h3esawy/OpenWaterHub/README.md

# OpenWaterHub
OpenWater Hub: An Open-Source Hardware Platform for Marine Robotics Support and Water Quality Data Acquisition
