h3esawy/OpenWaterHub/02_Mechanical_CAD/PortableLab_FrontPanel.DXF

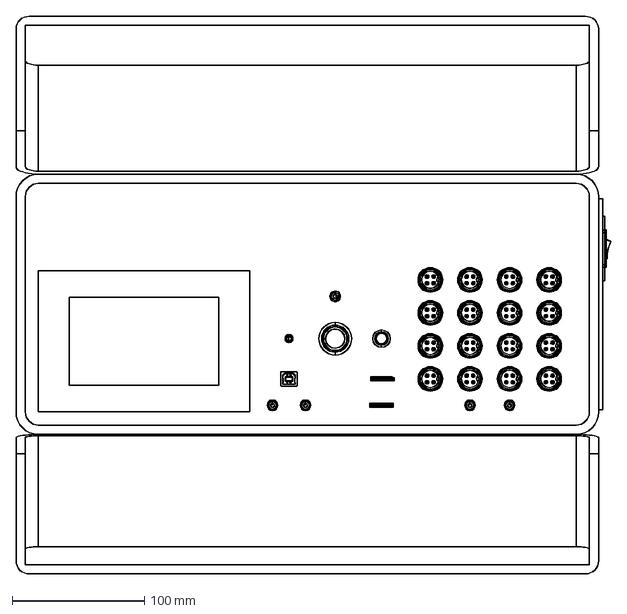
[picture p1: CAD file, 2026-06-13]
02_Mechanical_CAD/PortableLab_FrontPanel.DXF
450.4 x 422.2 mm
