h3esawy/OpenWaterHub/03_Firmware/ATmega128 MegaCore minimal setup.png

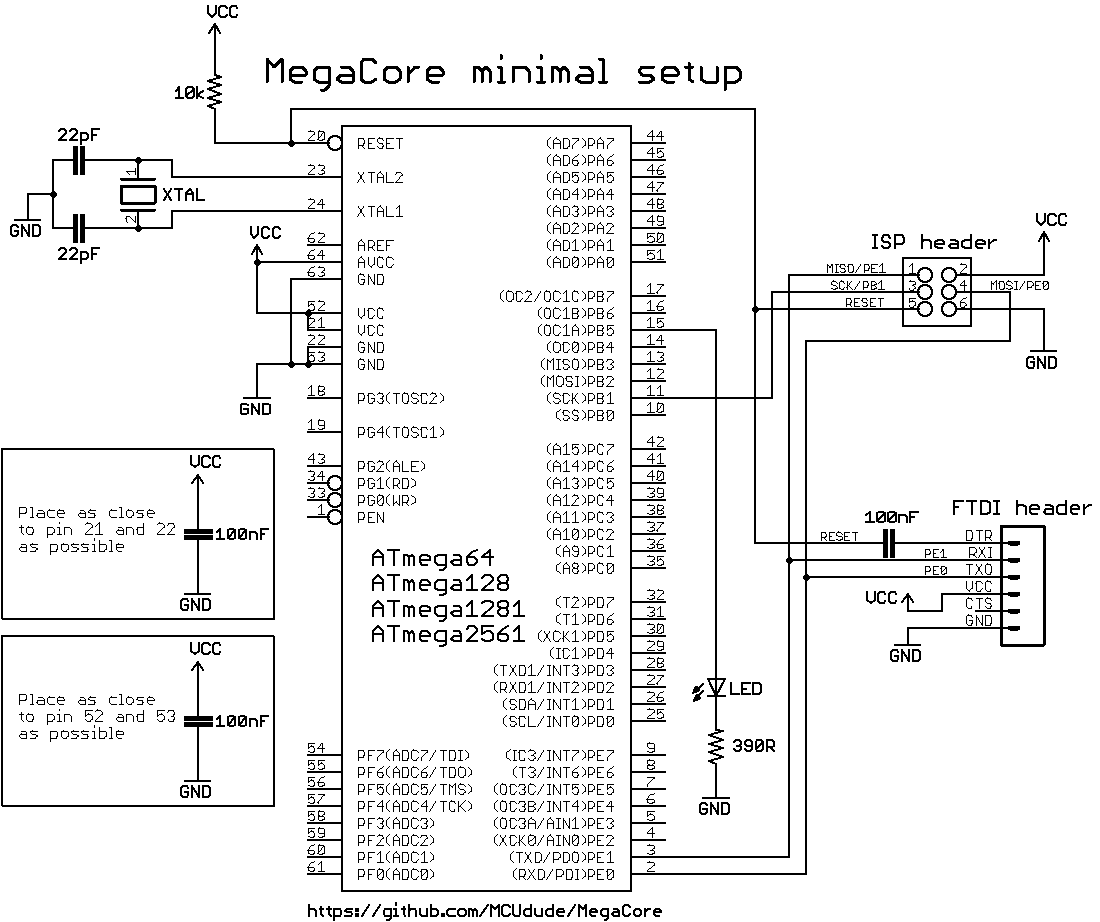
03_Firmware/ATmega128 MegaCore minimal setup.png
