h3esawy/OpenWaterHub/01_Hardware_PCB/OpenWaterHub_Schematic_Annotated.pdf

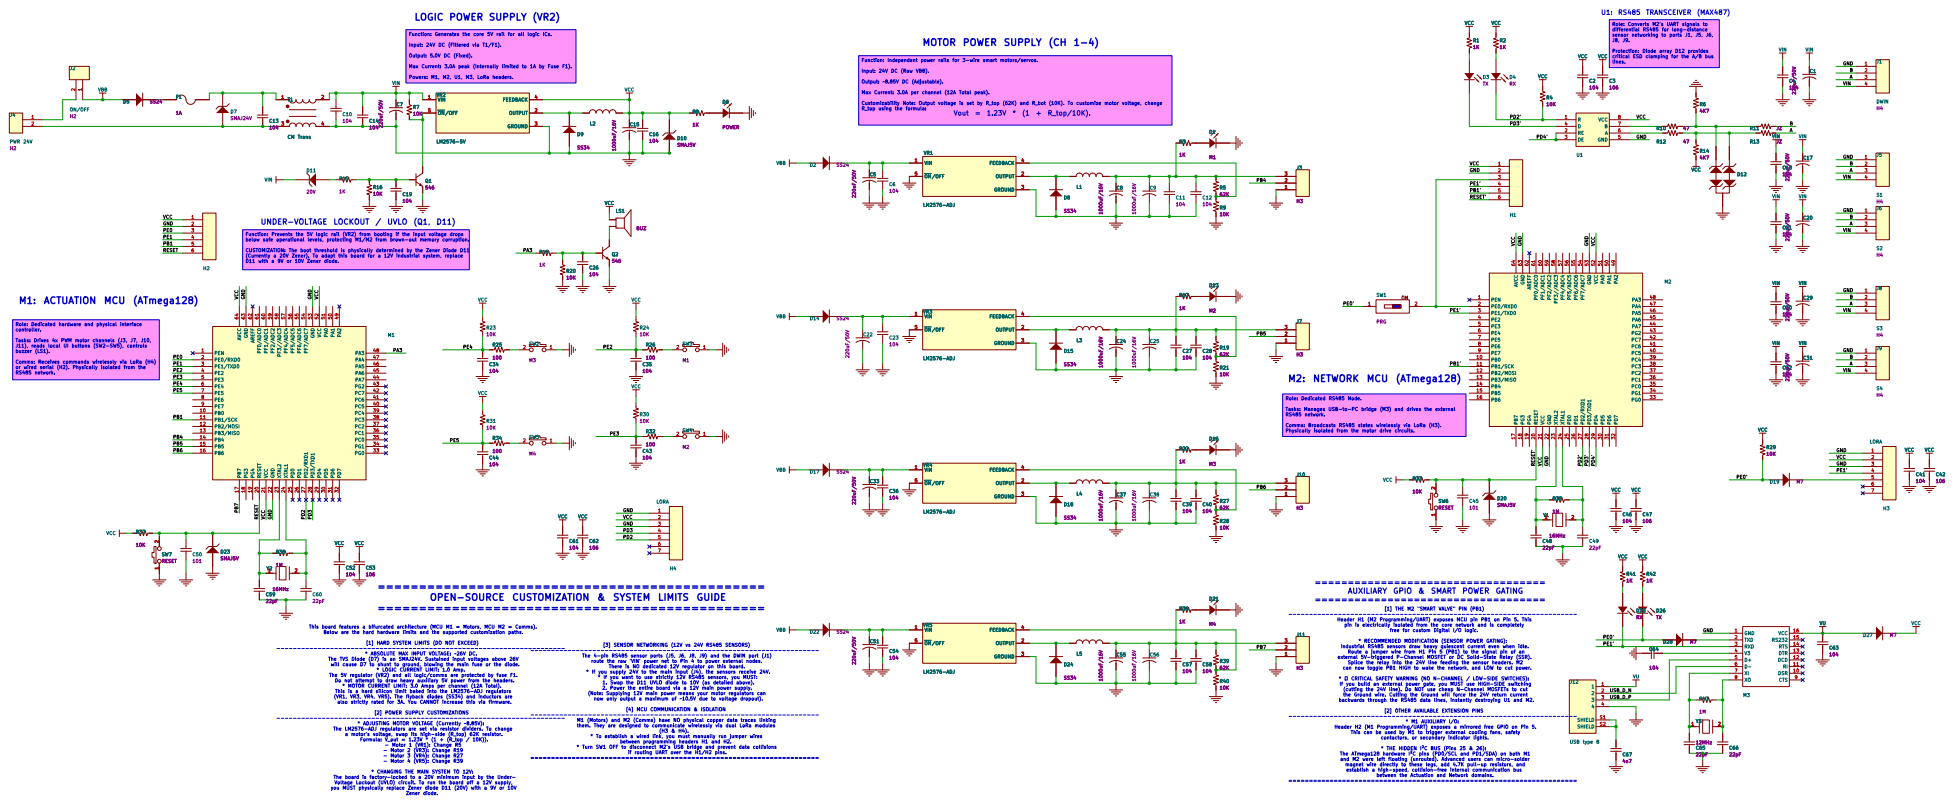
[picture p3: page 1]

Role: Converts M2's UART signals to
differential RS485 for long-distance

Function: Generates the core 5V rail for all logic ICs.

Input: 24V DC (Filtered via T1/F1).

Function: Independent power rails for 3-wire smart motors/servos.

lines. Role: Dedicated RS485 Node. Tasks: Manages USB-to-PC bridge (M3) and drives the external RS485 network. Comms: Broadcasts RS485 states wirelessly via LoRa (H3).

Input: 24V DC (Raw VBB).

Output: ~8.85V DC (Adjustable). Max Current: 3.0A per channel (12A Total peak).

UNDER-VOLTAGE LOCKOUT / UVLO (Q1, D11)

AUXILIARY GPIO & SMART POWER GATING =================================== M2: NETWORK MCU (ATmega128)

OPEN-SOURCE CUSTOMIZATION & SYSTEM LIMITS GUIDE

[1] THE M2 "SMART VALVE" PIN (PB1) ----------------------------------------------------------------------

free for custom Digital I/O logic. * RECOMMENDED MODIFICATION (SENSOR POWER GATING):

[1] HARD SYSTEM LIMITS (DO NOT EXCEED) ----------------------------------------------------------------------

[3] SENSOR NETWORKING (12V vs 24V RS485 SENSORS) ----------------------------------------------------------------------

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

* ABSOLUTE MAX INPUT VOLTAGE: ~26V DC.

route the raw 'VIN' power net to Pin 4 to power external nodes.

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

This is a hard silicon limit baked into the LM2576-ADJ regulators

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

M1 (Motors) and M2 (Comms) have NO physical copper data traces linking

* ADJUSTING MOTOR VOLTAGE (Currently ~8.85V):

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

* Turn SW1 OFF to disconnect M2's USB bridge and prevent data collisions

if routing UART over the H1/H2 pins. ======================================================================

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

you MUST physically replace Zener diode D11 (20V) with a 9V or 10V Zener diode.
