h3esawy/OpenWaterHub/(list of files, drawings)

Other design files:
01_Hardware_PCB/Altium_Source_Files/Schematic.SchDoc
01_Hardware_PCB/Altium_Source_Files/WaterRobot.PrjPcb
