h3esawy/OpenWaterHub/01_Hardware_PCB/KiCad_Source_Files/OpenWaterHub.kicad_sch

## KiCad design 01_Hardware_PCB/KiCad_Source_Files/OpenWaterHub.kicad_sch (2026-06-14)

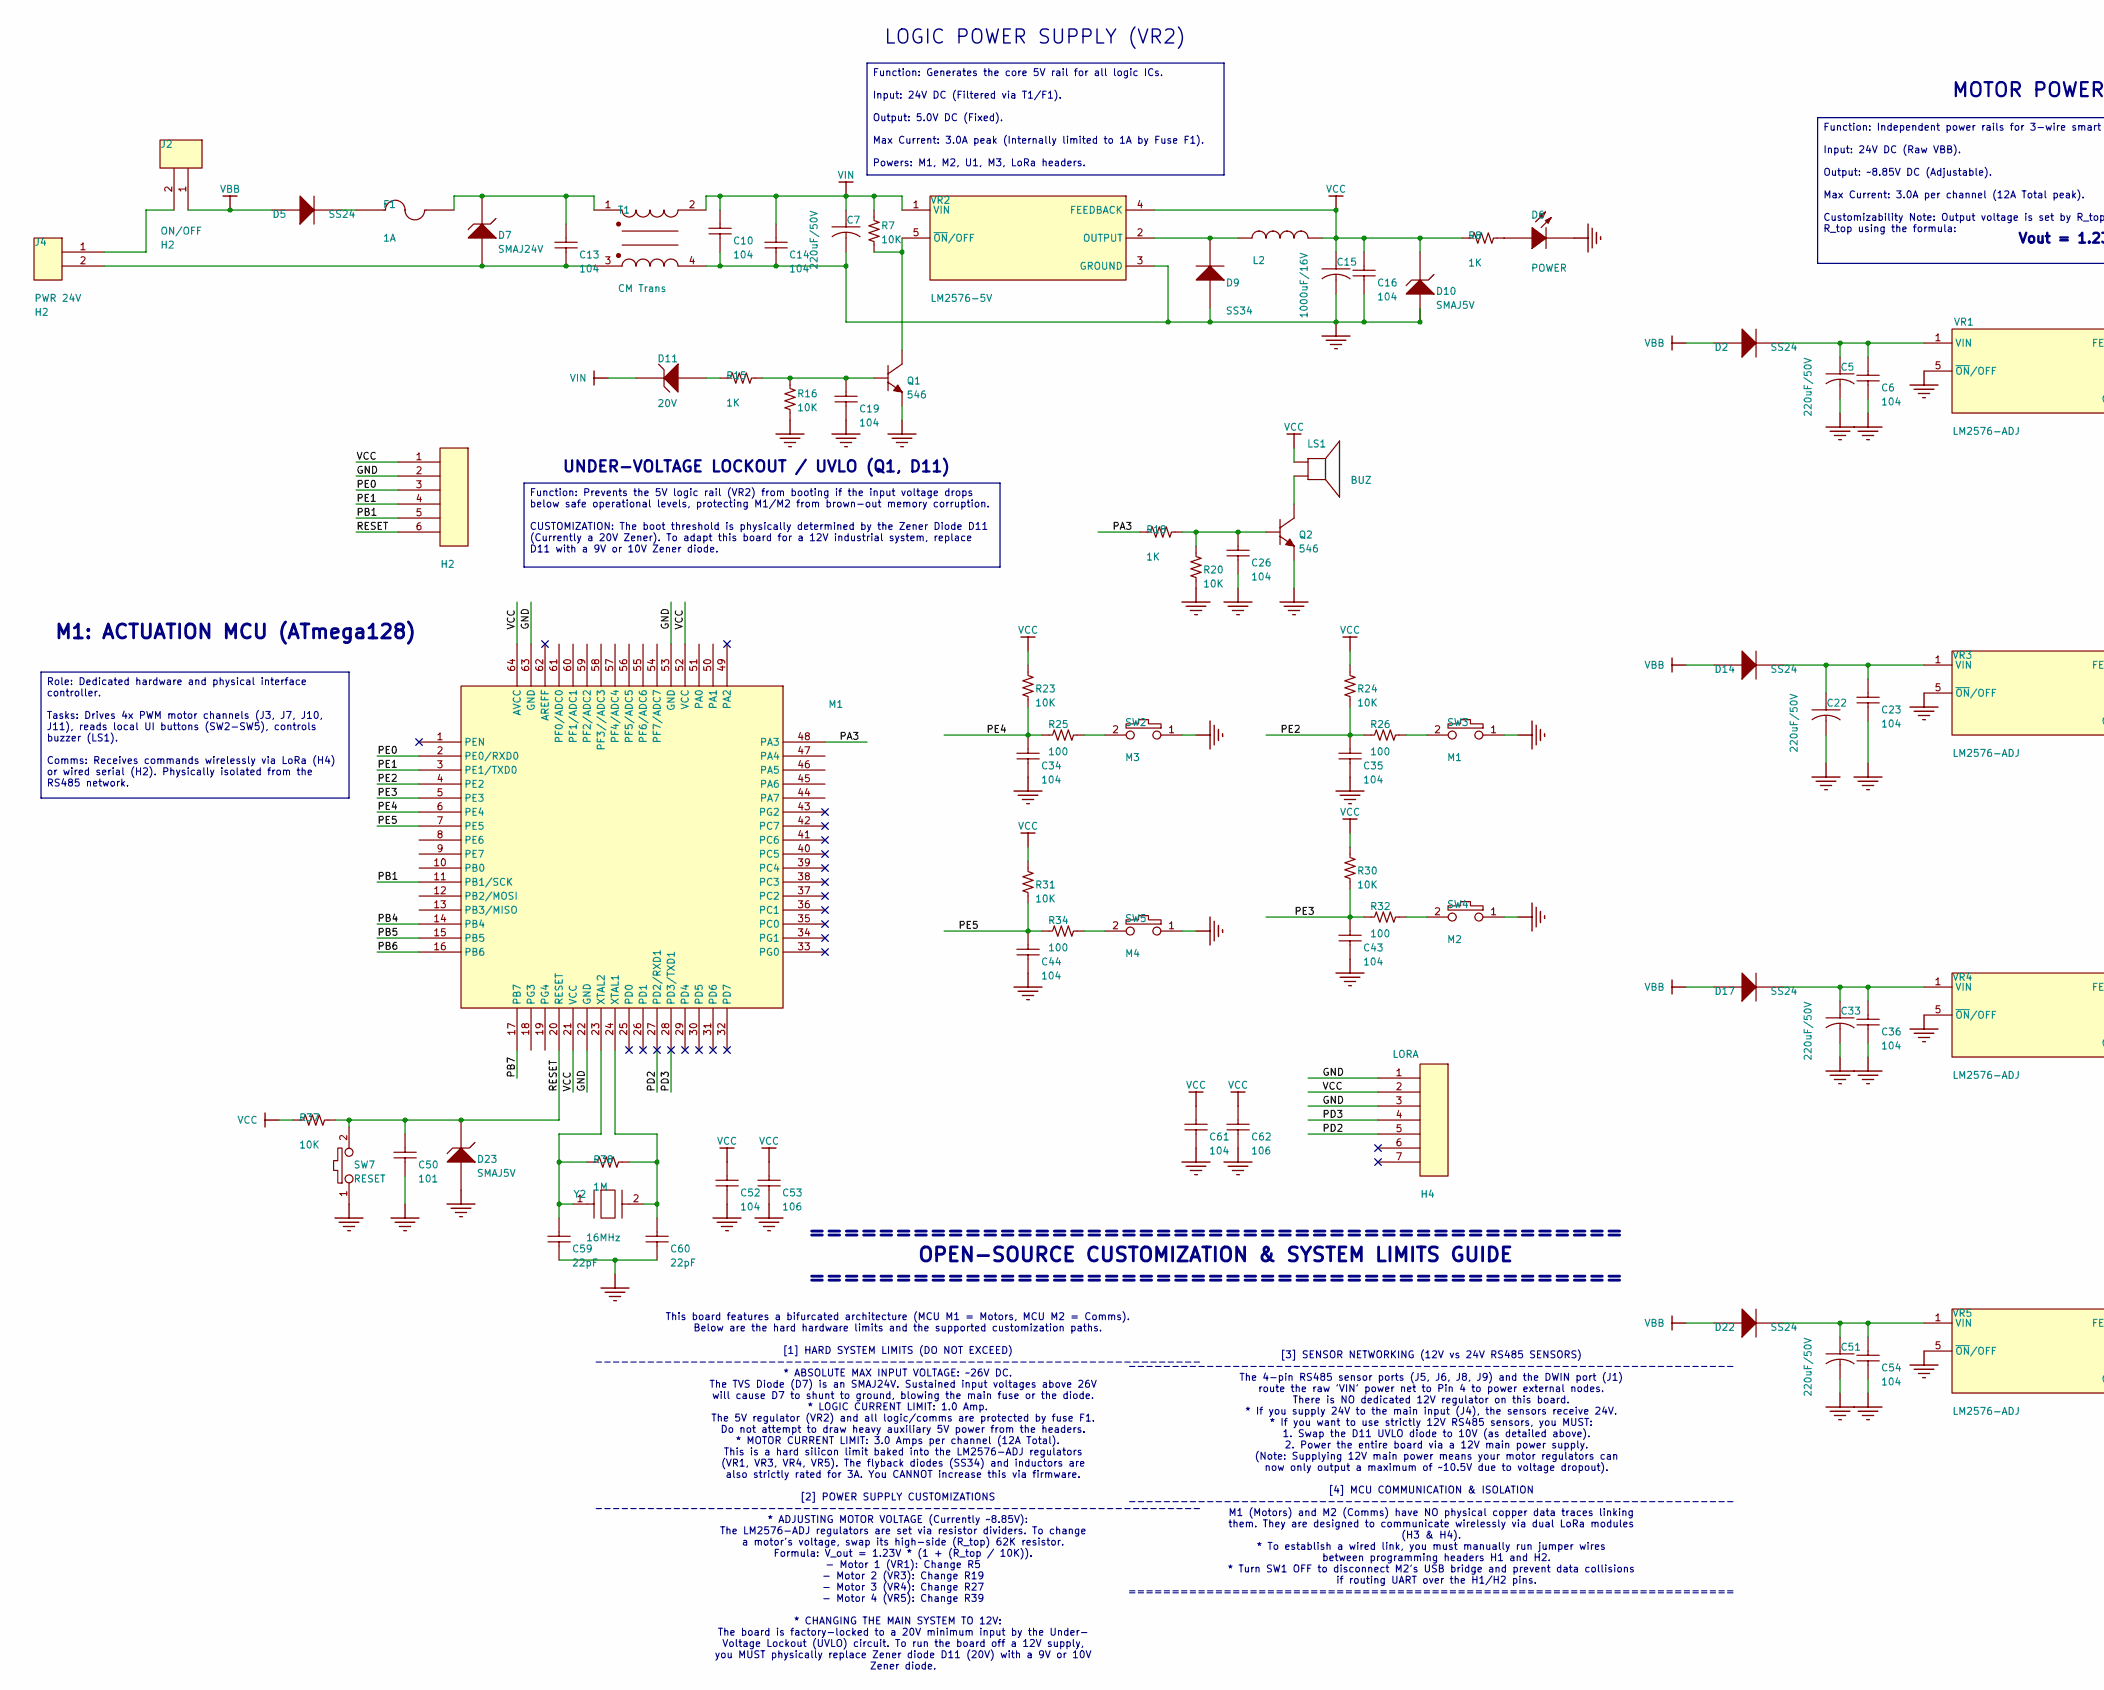
[picture p4: schematic OpenWaterHub.kicad_sch, part in row 1, column 1]

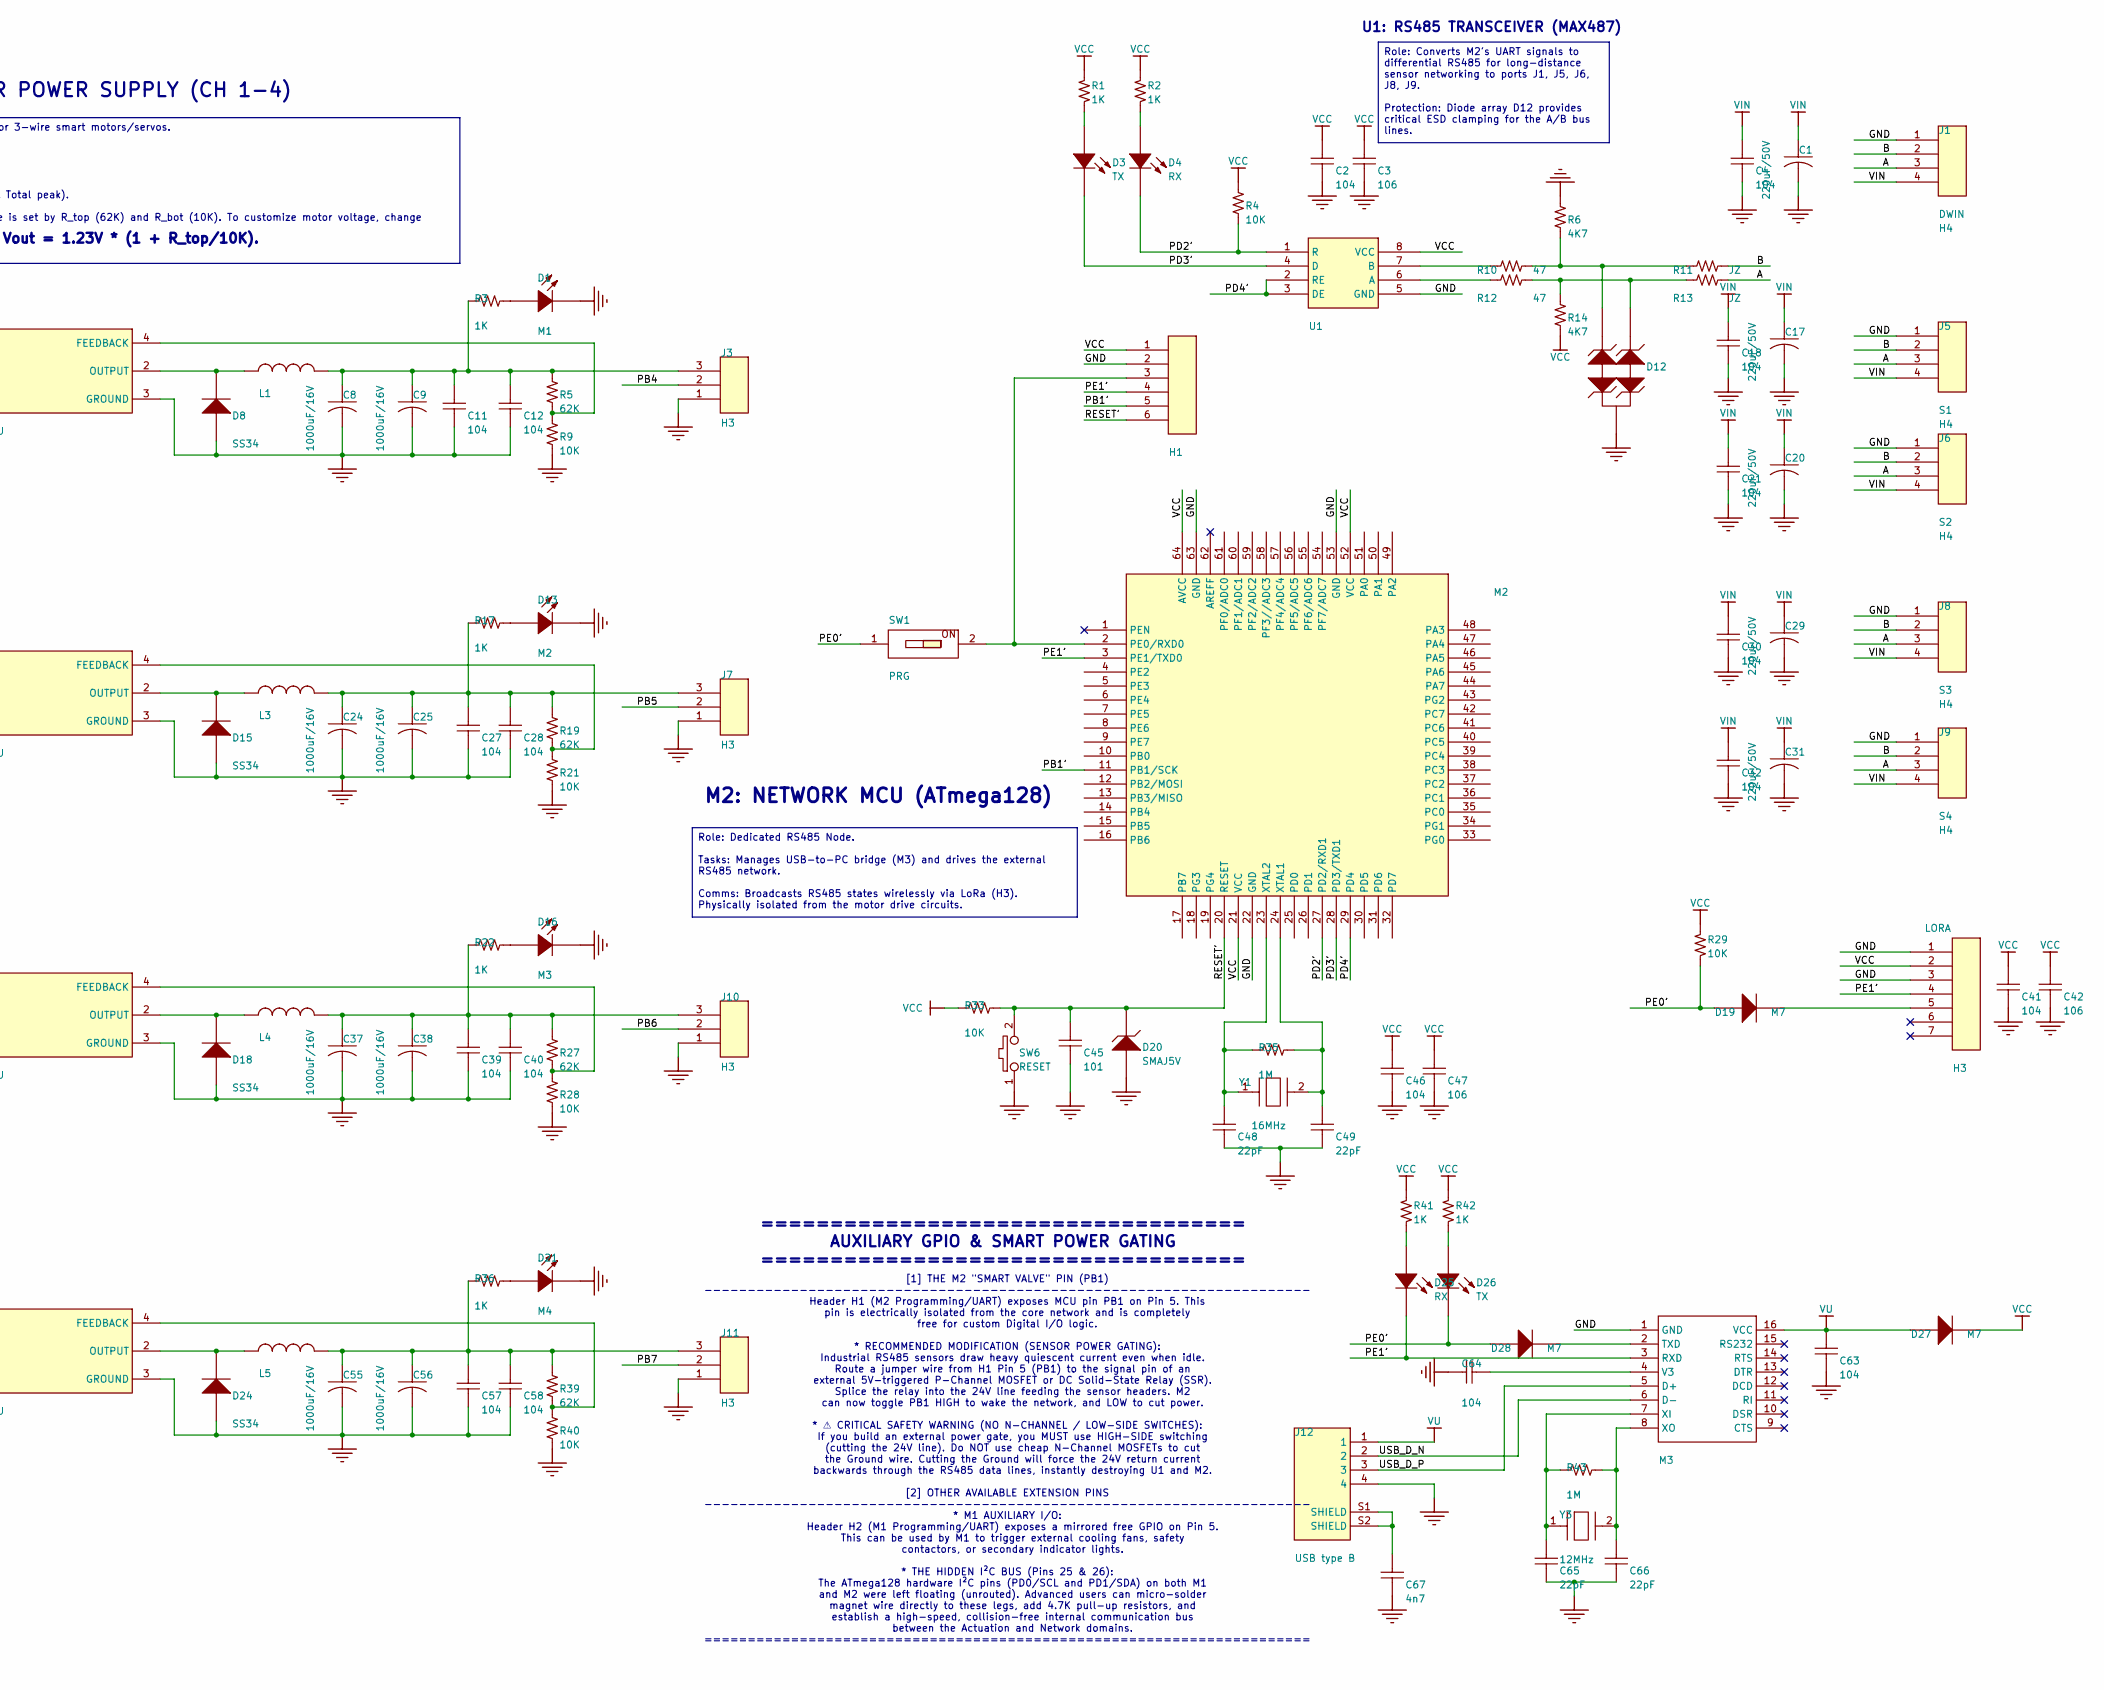
[picture p5: schematic OpenWaterHub.kicad_sch, part in row 1, column 2]

Parts:
C1, C5, C7, C17, C20, C22, C29, C31, C33, C51: CAP POL; CAP-P-1W
C2, C3, C4, C6, C11, C12, C14, C16, C18, C19, C21, C23, C26, C27, C28, C30, C32, C34, C35, C36, C39, C40, C41, C42, C43, C44, C45, C46, C47, C48, C49, C50, C52, C53, C54, C57, C58, C59, C60, C61, C62, C63, C64, C65, C66, C67: Cap; C-1206
C8, C9, C15, C24, C25, C37, C38, C55, C56: CAP POL; CAP-P-2
C10, C13: Cap; CAP-NP-1
D1, D6, D13, D16, D21: PWR; L-1206
D2, D5, D14, D17, D22: Diode; SMB
D3, D26: TX; L-1206
D4, D25: RX; L-1206
D7, D10, D20, D23: Zener Diode; SMA
D8, D9, D15, D18, D19, D24, D27, D28: Diode; SMA
D11: Zener Diode; ZDiode-3
D12: PSM712; SOT23
F1: Fuse; FUSE
H1, H2: H_1X6; Header-01X06
H3, H4: LORA; Header-01X07
J1: DWIN; STD-04-3.55MM
J2: ON/OFF; PLG-02-B
J3: MOTOR1; PLG-03-B
J4: PWR 24V; PLG-02-B
J5: S1; STD-04-3.55MM
J6: S2; STD-04-3.55MM
J7: MOTOR2; PLG-03-B
J8: S3; STD-04-3.55MM
J9: S4; STD-04-3.55MM
J10: MOTOR3; PLG-03-B
J11: MOTOR4; PLG-03-B
J12: USB type B; USB-Type-B
L1, L2, L3, L4, L5: Inductor; L_9X12
LS1: Buzzer
M1, M2: Atmega128-SMD; Quad64
M3: CH340; SOIC-16
Q1, Q2: NPN; SOT23
R1, R2, R3, R4, R5, R6, R7, R8, R9, R10, R11, R12, R13, R14, R15, R16, R17, R18, R19, R20, R21, R22, R23, R24, R25, R26, R27, R28, R29, R30, R31, R32, R33, R34, R35, R36, R37, R38, R39, R40, R41, R42, R43: Resistor; R-1206
SW1: SW-DIP01; SW-DIP-01
SW2: SET; SW-SPST-4-B
SW3: UP; SW-SPST-4-B
SW4: DOWN; SW-SPST-4-B
SW5: ENTER; SW-SPST-4-B
SW6, SW7: RESET; SW-SPST-4
T1: CM Trans; CM_UU9.8
U1: MAX487; SOIC_8
VR1, VR3, VR4, VR5: LM2576-ADJ; TO263_5
VR2: LM2576-5V; TO263_5
Y1, Y2, Y3: Crystal

Connections:
A: J1.3, J5.3, J6.3, J8.3, J9.3, R13.2
B: J1.2, J5.2, J6.2, J8.2, J9.2, R11.2
GND: C1.2, C2.1, C3.1, C4.1, C5.2, C6.1, C7.2, C8.2, C9.2, C10.1, C11.1, C12.1, C14.1, C15.2, C16.1, C17.2, C18.1, C19.1, C20.2, C21.1, C22.2, C23.1, C24.2, C25.2, C26.1, C27.1, C28.1, C29.2, C30.1, C31.2, C32.1, C33.2, C34.1, C35.1, C36.1, C37.2, C38.2, C39.1, C40.1, C41.1, C42.1, C43.1, C44.1, C45.1, C46.1, C47.1, C48.1, C49.1, C50.1, C51.2, C52.1, C53.1, C54.1, C55.2, C56.2, C57.1, C58.1, C59.1, C60.1, C61.1, C62.1, C63.1, C64.1, C65.1, C66.1, C67.1, D1.2 (K), D6.2 (K), D8.1 (A), D9.1 (A), D10.1 (A), D12.1 (A), D13.2 (K), D15.1 (A), D16.2 (K), D18.1 (A), D20.1 (A), D21.2 (K), D23.1 (A), D24.1 (A), H1.2, H2.2, H3.1, H3.3, H4.1, H4.3, J1.1, J3.1, J5.1, J6.1, J7.1, J8.1, J9.1, J10.1, J11.1, J12.4, M1.22 (GND), M1.53 (GND), M1.63 (GND), M2.22 (GND), M2.53 (GND), M2.63 (GND), M3.1 (GND), Q1.3 (E), Q2.3 (E), R6.2, R9.1, R16.2, R20.1, R21.1, R28.1, R40.1, SW2.1, SW3.1, SW4.1, SW5.1, SW6.1, SW7.1, T1.4 (3), U1.5 (GND), VR1.3 (GROUND), VR1.5 (~ON/OFF), VR2.3 (GROUND), VR3.3 (GROUND), VR3.5 (~ON/OFF), VR4.3 (GROUND), VR4.5 (~ON/OFF), VR5.3 (GROUND), VR5.5 (~ON/OFF)
unnamed: C5.1, C6.2, D2.2 (K), VR1.1 (VIN)
unnamed: C8.1, C9.1, C11.2, C12.2, J3.3, L1.2, R3.1, R5.2
unnamed: C13.1, D7.1 (A), J4.2, T1.3 (4)
unnamed: C13.2, D7.2 (K), F1.2, T1.1
unnamed: C19.2, Q1.2 (B), R15.2, R16.1
unnamed: C22.1, C23.2, D14.2 (K), VR3.1 (VIN)
unnamed: C24.1, C25.1, C27.2, C28.2, J7.3, L3.2, R17.1, R19.2
unnamed: C26.2, Q2.2 (B), R18.2, R20.2
unnamed: C33.1, C36.2, D17.2 (K), VR4.1 (VIN)
unnamed: C37.1, C38.1, C39.2, C40.2, J10.3, L4.2, R22.1, R27.2
unnamed: C48.2, M2.23 (XTAL2), R35.1, Y1.1
unnamed: C49.2, M2.24 (XTAL1), R35.2, Y1.2
unnamed: C51.1, C54.2, D22.2 (K), VR5.1 (VIN)
unnamed: C55.1, C56.1, C57.2, C58.2, J11.3, L5.2, R36.1, R39.2
unnamed: C59.2, M1.23 (XTAL2), R38.1, Y2.1
unnamed: C60.2, M1.24 (XTAL1), R38.2, Y2.2
unnamed: C64.2, M3.4 (V3)
unnamed: C65.2, M3.7 (XI), R43.1, Y3.1
unnamed: C66.2, M3.8 (XO), R43.2, Y3.2
unnamed: C67.2, J12.S1 (SHIELD), J12.S2 (SHIELD)
unnamed: D1.1 (A), R3.2
unnamed: D3.1 (A), R1.2
unnamed: D4.1 (A), R2.2
unnamed: D5.2 (K), F1.1
unnamed: D6.1 (A), R8.2
unnamed: D8.2 (K), L1.1, VR1.2 (OUTPUT)
unnamed: D9.2 (K), L2.1, VR2.2 (OUTPUT)
unnamed: D11.1 (A), R15.1
unnamed: D12.2 (K), R6.1, R10.2, R11.1
unnamed: D12.3 (K), R12.2, R13.1, R14.2
unnamed: D13.1 (A), R17.2
unnamed: D15.2 (K), L3.1, VR3.2 (OUTPUT)
unnamed: D16.1 (A), R22.2
unnamed: D18.2 (K), L4.1, VR4.2 (OUTPUT)
unnamed: D19.2 (K), H3.5
unnamed: D21.1 (A), R36.2
unnamed: D24.2 (K), L5.1, VR5.2 (OUTPUT)
unnamed: D25.1 (A), R41.2
unnamed: D26.1 (A), R42.2
unnamed: D28.2 (K), M3.2 (TXD)
unnamed: H1.3, M2.2 (PE0/RXD0), SW1.2
unnamed: J2.2, J4.1
unnamed: LS1.2, Q2.1 (C)
unnamed: Q1.1 (C), R7.2, VR2.5 (~ON/OFF)
unnamed: R5.1, R9.2, VR1.4 (FEEDBACK)
unnamed: R10.1, U1.7 (B)
unnamed: R12.1, U1.6 (A)
unnamed: R19.1, R21.2, VR3.4 (FEEDBACK)
unnamed: R25.1, SW2.2
unnamed: R26.1, SW3.2
unnamed: R27.1, R28.2, VR4.4 (FEEDBACK)
unnamed: R32.1, SW4.2
unnamed: R34.1, SW5.2
unnamed: R39.1, R40.2, VR5.4 (FEEDBACK)
PA3: M1.48 (PA3), R18.1
PB1: H2.5, M1.11 (PB1/SCK)
PB1': H1.5, M2.11 (PB1/SCK)
PB4: J3.2, M1.14 (PB4)
PB5: J7.2, M1.15 (PB5)
PB6: J10.2, M1.16 (PB6)
PB7: J11.2, M1.17 (PB7)
PD2: H4.5, M1.27 (PD2/RXD1)
PD2': D4.2 (K), M2.27 (PD2/RXD1), R4.1, U1.1 (R)
PD3: H4.4, M1.28 (PD3/TXD1)
PD3': D3.2 (K), M2.28 (PD3/TXD1), U1.4 (D)
PD4': M2.29 (PD4), U1.2 (RE), U1.3 (DE)
PE0: H2.3, M1.2 (PE0/RXD0)
PE0': D19.1 (A), D26.2 (K), D28.1 (A), R29.2, SW1.1
PE1: H2.4, M1.3 (PE1/TXD0)
PE1': D25.2 (K), H1.4, H3.4, M2.3 (PE1/TXD0), M3.3 (RXD)
PE2: C35.2, M1.4 (PE2), R24.1, R26.2
PE3: C43.2, M1.5 (PE3), R30.1, R32.2
PE4: C34.2, M1.6 (PE4), R23.1, R25.2
PE5: C44.2, M1.7 (PE5), R31.1, R34.2
RESET: C50.2, D23.2 (K), H2.6, M1.20 (RESET), R37.2, SW7.2
RESET': C45.2, D20.2 (K), H1.6, M2.20 (RESET), R33.2, SW6.2
USB_D_N: J12.2, M3.6 (D-)
USB_D_P: J12.3, M3.5 (D+)
VBB: D2.1 (A), D5.1 (A), D14.1 (A), D17.1 (A), D22.1 (A), J2.1
VCC: C2.2, C3.2, C15.1, C16.2, C41.2, C42.2, C46.2, C47.2, C52.2, C53.2, C61.2, C62.2, D10.2 (K), D27.2 (K), H1.1, H2.1, H3.2, H4.2, L2.2, LS1.1, M1.21 (VCC), M1.52 (VCC), M1.64 (AVCC), M2.21 (VCC), M2.52 (VCC), M2.64 (AVCC), R1.1, R2.1, R4.2, R8.1, R14.1, R23.2, R24.2, R29.1, R30.2, R31.2, R33.1, R37.1, R41.1, R42.1, U1.8 (VCC), VR2.4 (FEEDBACK)
VIN: C1.1, C4.2, C7.1, C10.2, C14.2, C17.1, C18.2, C20.1, C21.2, C29.1, C30.2, C31.1, C32.2, D11.2 (K), J1.4, J5.4, J6.4, J8.4, J9.4, R7.1, T1.2, VR2.1 (VIN)
VU: C63.2, D27.1 (A), J12.1, M3.16 (VCC)

Notes on the sheet:
This board features a bifurcated architecture (MCU M1 = Motors, MCU M2 = Comms). Below are the hard hardware limits and the supported customization paths. [1] HARD SYSTEM LIMITS (DO NOT EXCEED) ---------------------------------------------------------------------- * ABSOLUTE MAX INPUT VOLTAGE: ~26V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
MOTOR POWER SUPPLY (CH 1-4)
=================================== AUXILIARY GPIO & SMART POWER GATING ===================================
U1: RS485 TRANSCEIVER (MAX487)
M1: ACTUATION MCU (ATmega128)
M2: NETWORK MCU (ATmega128)
[3] SENSOR NETWORKING (12V vs 24V RS485 SENSORS) ---------------------------------------------------------------------- The 4-pin RS485 sensor ports (J5, J6, J8, J9) and the DWIN port (J1) route the raw 'VIN' power net to Pin 4 to power external nodes. There is NO dedicated 12V regulator on this bo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
=============================================== OPEN-SOURCE CUSTOMIZATION & SYSTEM LIMITS GUIDE ===============================================
LOGIC POWER SUPPLY (VR2)
UNDER-VOLTAGE LOCKOUT / UVLO (Q1, D11)
Vout = 1.23V * (1 + R_top/10K).
[1] THE M2 "SMART VALVE" PIN (PB1) ---------------------------------------------------------------------- Header H1 (M2 Programming/UART) exposes MCU pin PB1 on Pin 5. This pin is electrically isolated from the core network and is completely free for custom Digital I/O logic. * RECOMMENDED MODIFICA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
Function: Prevents the 5V logic rail (VR2) from booting if the input voltage drops below safe operational levels, protecting M1/M2 from brown-out memory corruption. CUSTOMIZATION: The boot threshold is physically determined by the Zener Diode D11 (Currently a 20V Zener). To adapt this board for a 1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
Function: Generates the core 5V rail for all logic ICs. Input: 24V DC (Filtered via T1/F1). Output: 5.0V DC (Fixed). Max Current: 3.0A peak (Internally limited to 1A by Fuse F1). Powers: M1, M2, U1, M3, LoRa headers.
Role: Converts M2's UART signals to differential RS485 for long-distance sensor networking to ports J1, J5, J6, J8, J9. Protection: Diode array D12 provides critical ESD clamping for the A/B bus lines.
Function: Independent power rails for 3-wire smart motors/servos. Input: 24V DC (Raw VBB). Output: ~8.85V DC (Adjustable). Max Current: 3.0A per channel (12A Total peak). Customizability Note: Output voltage is set by R_top (62K) and R_bot (10K). To customize motor voltage, change R_top using the f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
Role: Dedicated hardware and physical interface controller. Tasks: Drives 4x PWM motor channels (J3, J7, J10, J11), reads local UI buttons (SW2-SW5), controls buzzer (LS1). Comms: Receives commands wirelessly via LoRa (H4) or wired serial (H2). Physically isolated from the RS485 network.
Role: Dedicated RS485 Node. Tasks: Manages USB-to-PC bridge (M3) and drives the external RS485 network. Comms: Broadcasts RS485 states wirelessly via LoRa (H3). Physically isolated from the motor drive circuits.
