h3esawy/OpenWaterHub/(commit log)

2026-06-13 Added 01_Hardware_PCB
    [BOM_Actuation_Node_M1_Only.csv, BOM_Comms_Node_M2_Only.csv, BOM_Grouped.csv, BOM_M1M2_FullyPopulated.csv, OpenWaterHub.csv, OpenWaterHub.kicad_sch, Schematic.SchDoc, WaterRobot.PrjPcb]
2026-06-13 Added 02_Mechanical_CAD
    [PortableLab_FrontPanel.DXF]
2026-06-14 Updated Schematic Text Guides
    [OpenWaterHub.kicad_sch]
2026-06-14 Updated Schematic Text again
    [OpenWaterHub.kicad_sch]
2026-06-15 Fixed file name typos
    [MCU1_PermanentSleep.ino, MCU2_PermanentSleep.ino]
